cloudglides/glitch/image.png

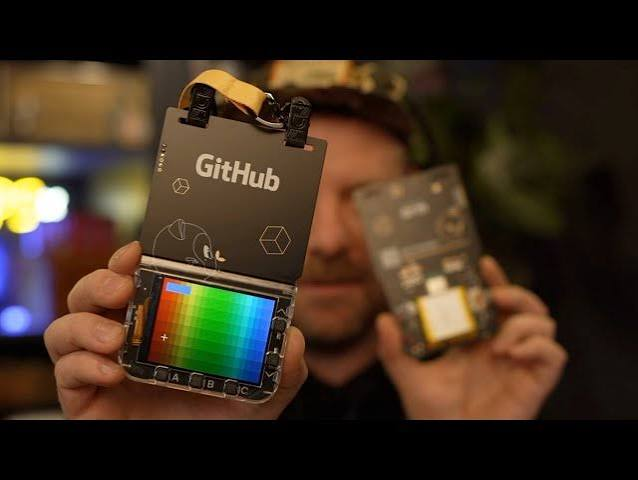
image.png
