cloudglides/glitch/images/1-placement-back-first-try.png

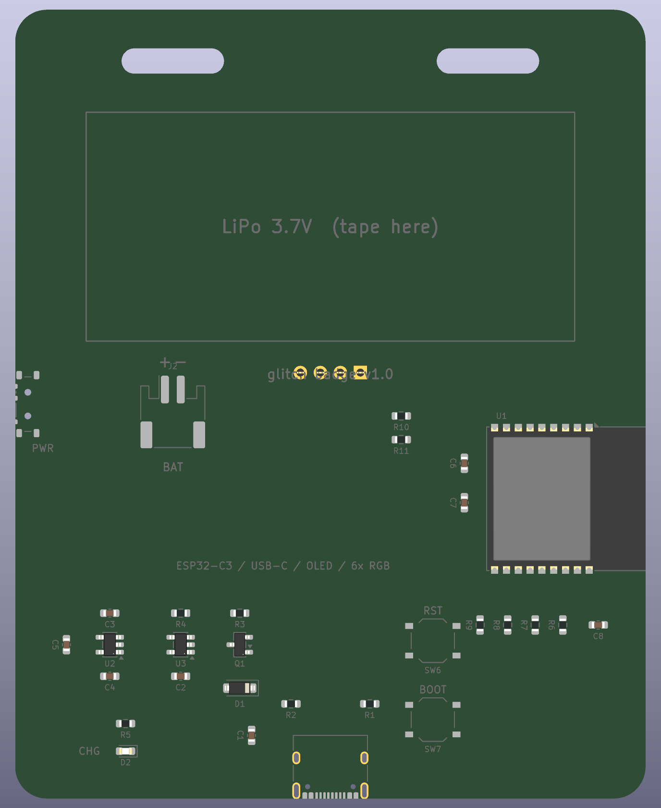
images/1-placement-back-first-try.png
