cloudglides/glitch/images/1-placement-front.png

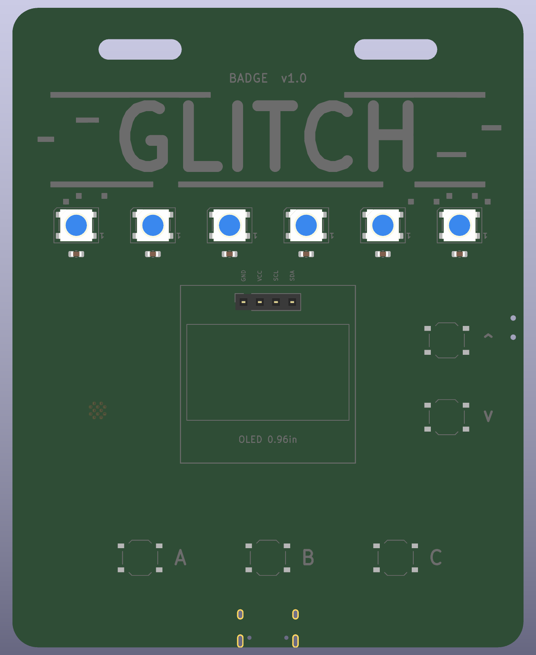
images/1-placement-front.png
