cloudglides/glitch/images/3-routing-back-layout.png

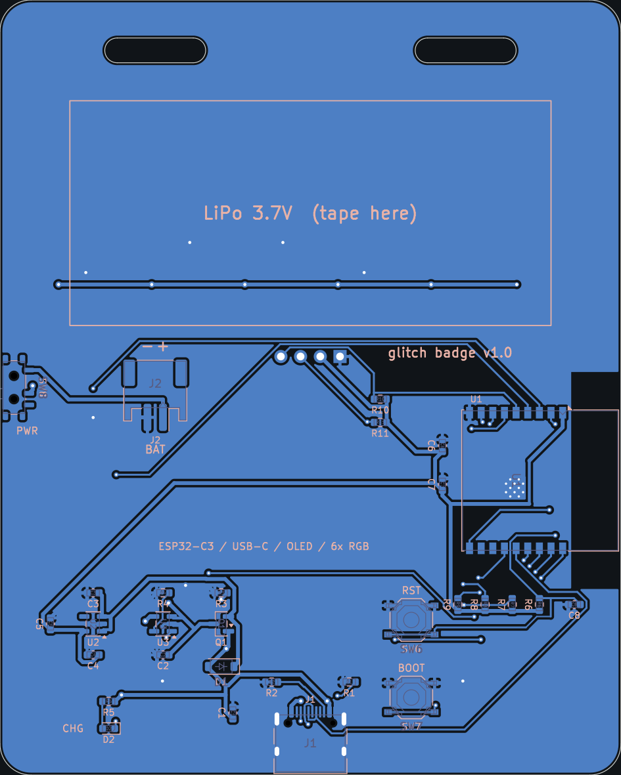
images/3-routing-back-layout.png
