cloudglides/glitch/images/3-routing-copper.png

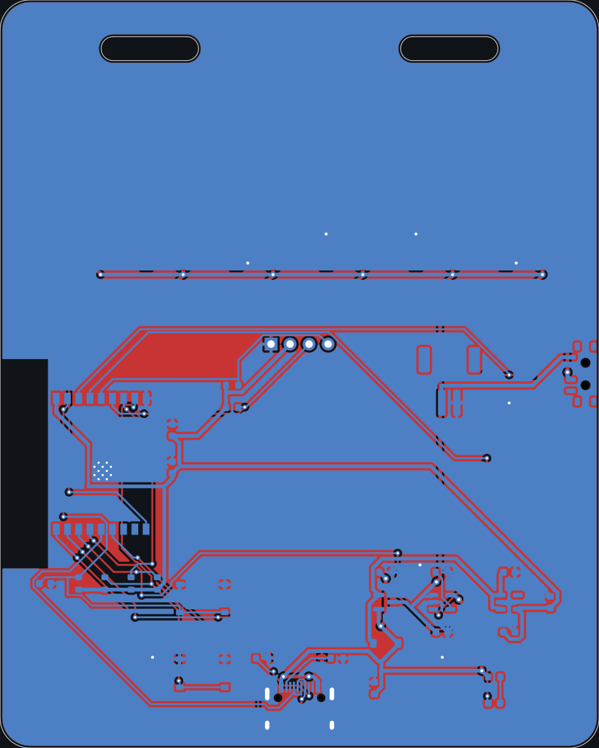
images/3-routing-copper.png
