cloudglides/glitch/BOM.csv

Comment | Designator | Footprint | LCSC Part # | Quantity
10uF | C1,C2,C3,C4,C6 | C_0603_1608Metric | C19702 | 5
100nF | C5,C7,C9,C10,C11,C12,C13,C14 | C_0603_1608Metric | C14663 | 8
1uF | C8 | C_0603_1608Metric | C15849 | 1
B5819W | D1 | D_SOD-123 | C8598 | 1
CHG red | D2 | LED_0603_1608Metric | C2286 | 1
USB-C 16P | J1 | USB_C_Receptacle_HRO_TYPE-C-31-M-12 | C165948 | 1
LiPo JST-PH | J2 | JST_PH_S2B-PH-SM4-TB_1x02-1MP_P2.00mm_Horizontal | C295747 | 1
OLED GND/VCC/SCL/SDA | J3 | PinSocket_1x04_P2.54mm_Vertical | C2718488 | 1
WS2812B | LED1,LED2,LED3,LED4,LED5,LED6 | LED_WS2812B_PLCC4_5.0x5.0mm_P3.2mm | C114586 | 6
AO3401A | Q1 | SOT-23 | C15127 | 1
5.1k | R1,R2,R4 | R_0603_1608Metric | C23186 | 3
100k | R3 | R_0603_1608Metric | C25803 | 1
1k | R5 | R_0603_1608Metric | C21190 | 1
10k | R6,R7,R8,R9 | R_0603_1608Metric | C25804 | 4
4.7k | R10,R11 | R_0603_1608Metric | C23162 | 2
A | SW1 | SW_Push_1P1T_XKB_TS-1187A | C318884 | 1
B | SW2 | SW_Push_1P1T_XKB_TS-1187A | C318884 | 1
C | SW3 | SW_Push_1P1T_XKB_TS-1187A | C318884 | 1
UP | SW4 | SW_Push_1P1T_XKB_TS-1187A | C318884 | 1
DOWN | SW5 | SW_Push_1P1T_XKB_TS-1187A | C318884 | 1
RESET | SW6 | SW_Push_1P1T_XKB_TS-1187A | C318884 | 1
BOOT | SW7 | SW_Push_1P1T_XKB_TS-1187A | C318884 | 1
POWER | SW8 | SW_SPDT_Shouhan_MSK12C02 | C431540 | 1
ESP32-C3-WROOM-02-N4 | U1 | ESP32-C3-WROOM-02 | C2934560 | 1
ME6211C33 | U2 | SOT-23-5 | C82942 | 1
TP4054 | U3 | SOT-23-5 | C32574 | 1
