cloudglides/glitch/docs/glitch-schematic.pdf

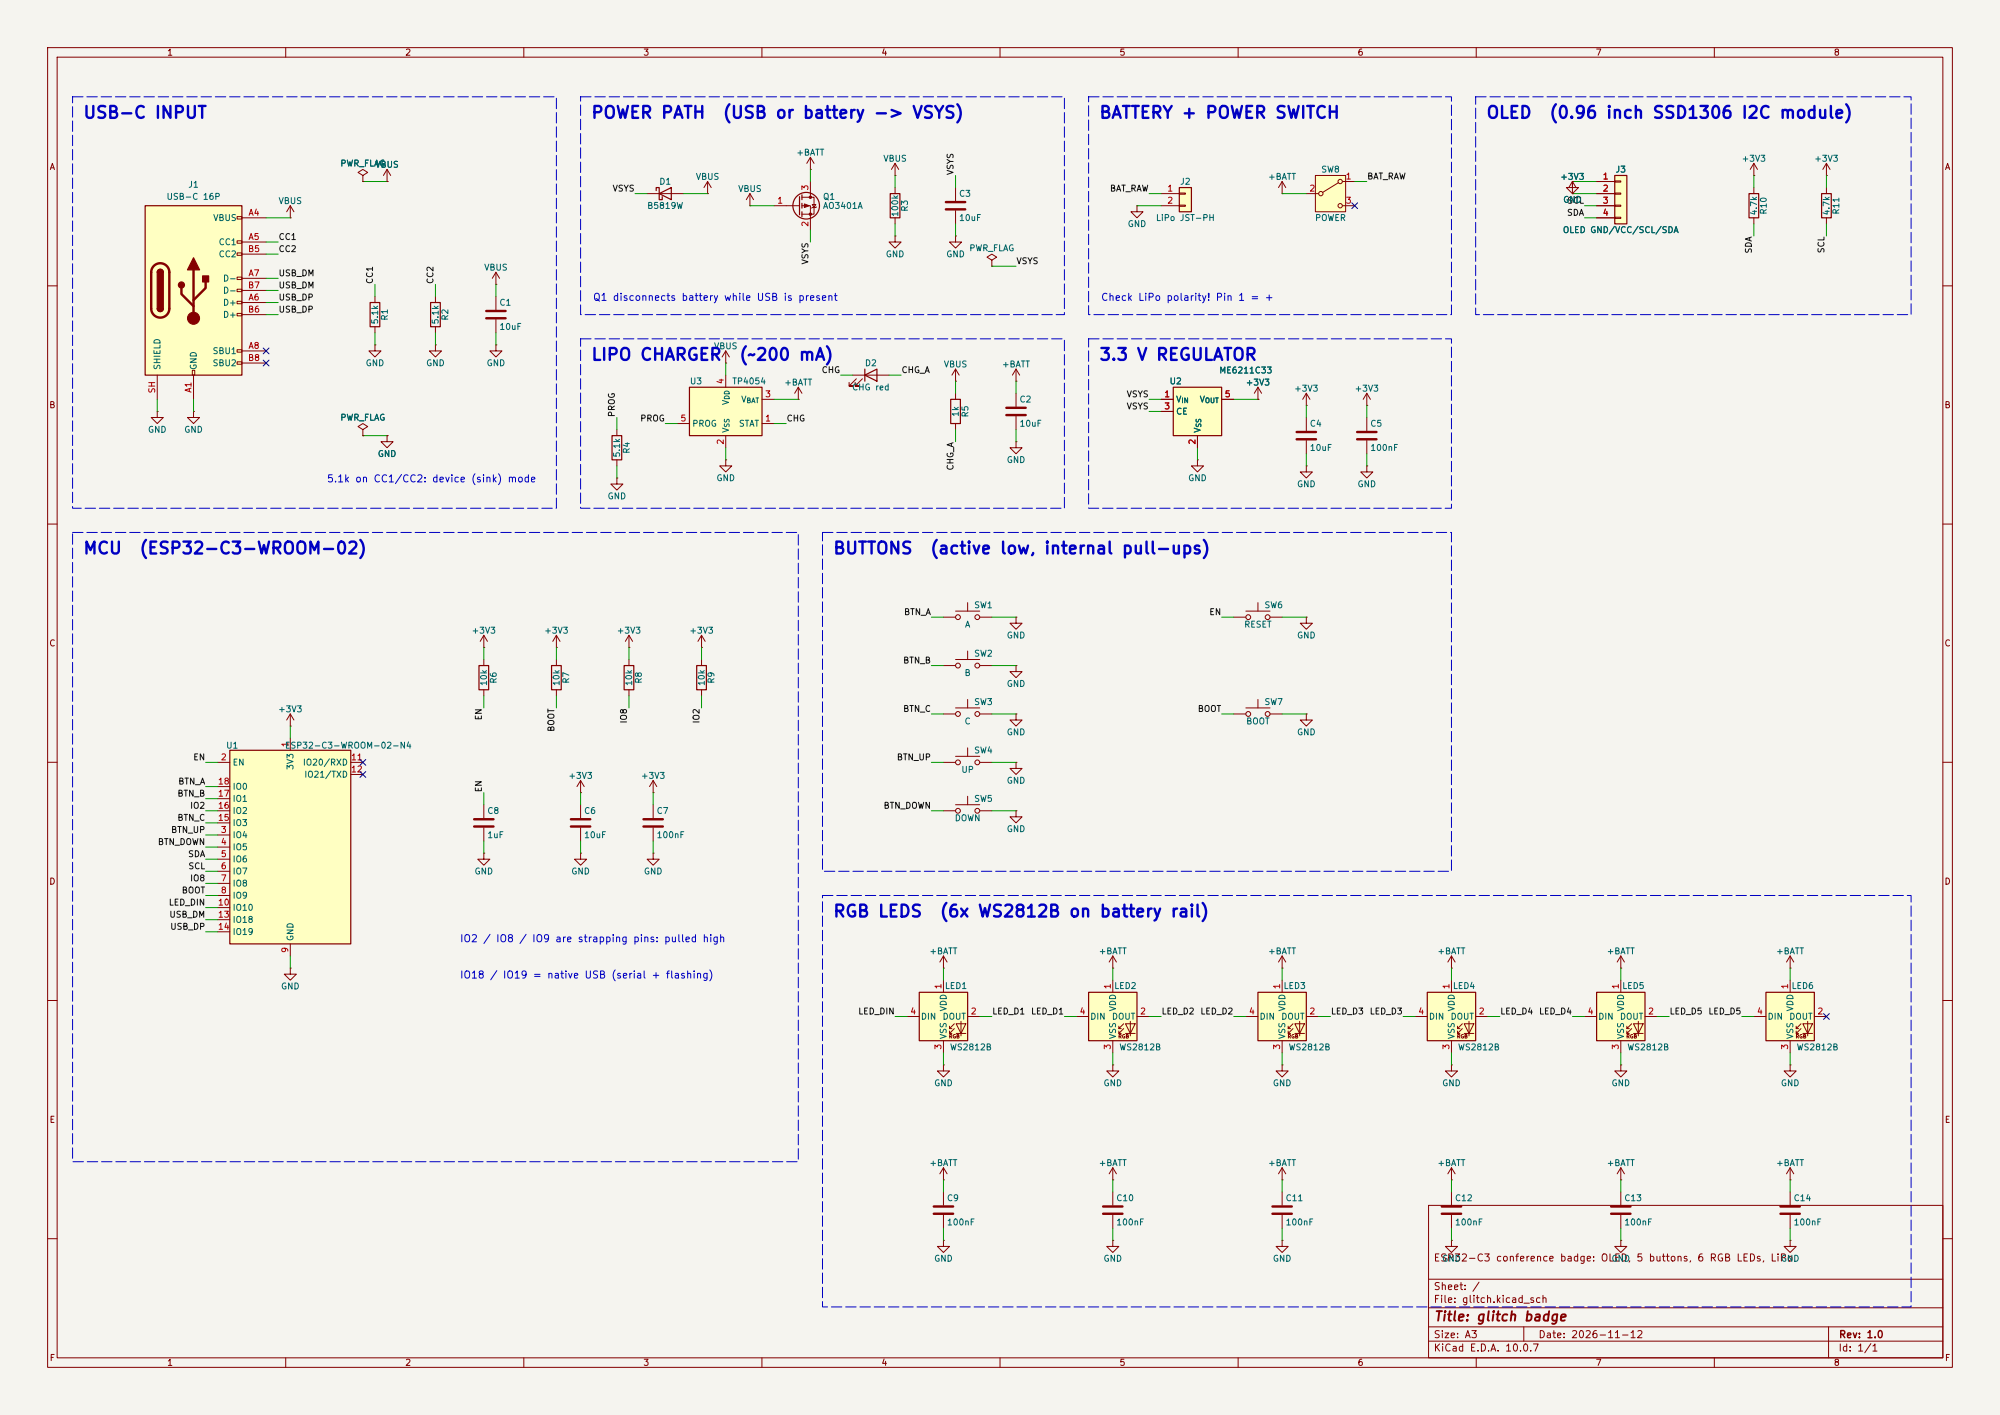
[picture p12: page 1]

POWER PATH (USB or battery -> VSYS)

J3 OLED GND/VCC/SCL/SDA +3V3 GND

Q1 disconnects battery while USB is present

Check LiPo polarity! Pin 1 = +

VDD 4 PROG 5 U3 TP4054 D2 CHG red GND +3V3 +3V3 C6

5.1k on CC1/CC2: device (sink) mode

RGB LEDS (6x WS2812B on battery rail)

IO2 / IO8 / IO9 are strapping pins: pulled high

IO18 / IO19 = native USB (serial + flashing)

ESP32-C3 conference badge: OLED, 5 buttons, 6 RGB LEDs, LiPo

GND

Sheet: / File: glitch.kicad_sch

Size: A3 | Rev: 1.0 | F Date: 2026-11-12
KiCad E.D.A. 10.0.7 | Id: 1/1
