cloudglides/glitch/pcb/glitch.kicad_pcb

## KiCad design pcb/glitch.kicad_pcb (2026-11-11)

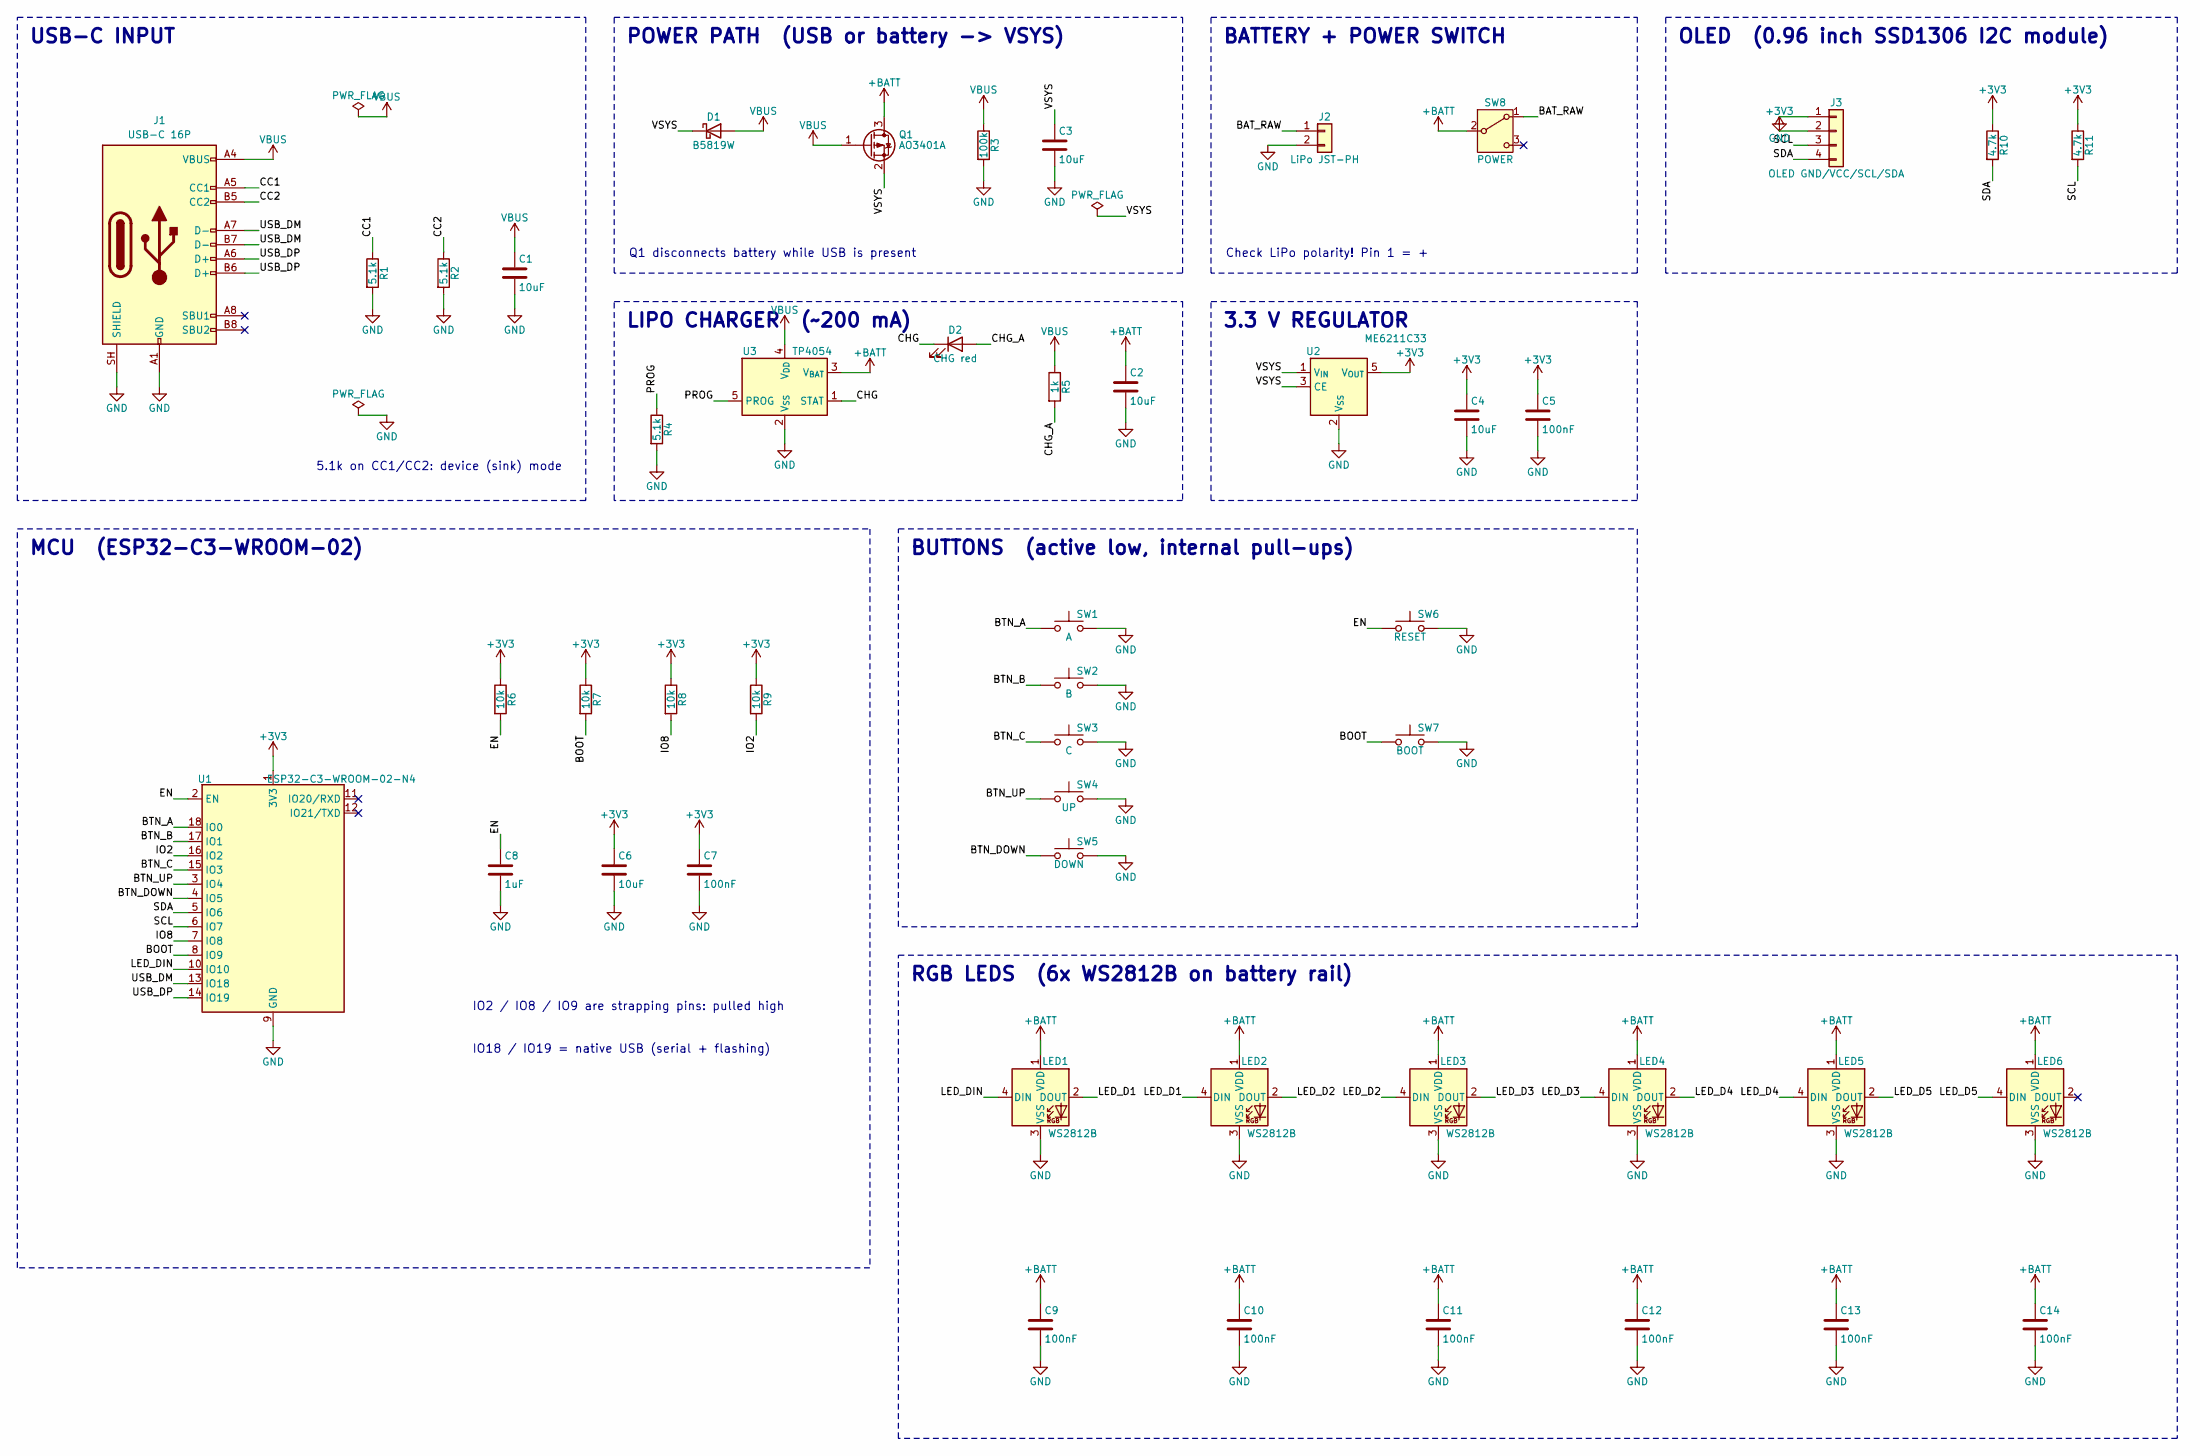
[picture p13: schematic glitch.kicad_sch, glitch badge]

Parts:
C1, C2, C3, C4, C6: 10uF; C_0603_1608Metric; LCSC C19702
C5, C7, C9, C10, C11, C12, C13, C14: 100nF; C_0603_1608Metric; LCSC C14663
C8: 1uF; C_0603_1608Metric; LCSC C15849
D1: B5819W; D_SOD-123; LCSC C8598
D2: CHG red; LED_0603_1608Metric; LCSC C2286
J1: USB-C 16P; USB_C_Receptacle_HRO_TYPE-C-31-M-12; LCSC C165948
J2: LiPo JST-PH; JST_PH_S2B-PH-SM4-TB_1x02-1MP_P2.00mm_Horizontal; LCSC C295747
J3: OLED GND/VCC/SCL/SDA; PinSocket_1x04_P2.54mm_Vertical; LCSC C2718488
LED1, LED2, LED3, LED4, LED5, LED6: WS2812B; LED_WS2812B_PLCC4_5.0x5.0mm_P3.2mm; LCSC C114586
Q1: AO3401A; SOT-23; LCSC C15127
R1, R2, R4: 5.1k; R_0603_1608Metric; LCSC C23186
R3: 100k; R_0603_1608Metric; LCSC C25803
R5: 1k; R_0603_1608Metric; LCSC C21190
R6, R7, R8, R9: 10k; R_0603_1608Metric; LCSC C25804
R10, R11: 4.7k; R_0603_1608Metric; LCSC C23162
SW1: A; SW_Push_1P1T_XKB_TS-1187A; LCSC C318884
SW2: B; SW_Push_1P1T_XKB_TS-1187A; LCSC C318884
SW3: C; SW_Push_1P1T_XKB_TS-1187A; LCSC C318884
SW4: UP; SW_Push_1P1T_XKB_TS-1187A; LCSC C318884
SW5: DOWN; SW_Push_1P1T_XKB_TS-1187A; LCSC C318884
SW6: RESET; SW_Push_1P1T_XKB_TS-1187A; LCSC C318884
SW7: BOOT; SW_Push_1P1T_XKB_TS-1187A; LCSC C318884
SW8: POWER; SW_SPDT_Shouhan_MSK12C02; LCSC C431540
U1: ESP32-C3-WROOM-02-N4; ESP32-C3-WROOM-02; LCSC C2934560
U2: ME6211C33; SOT-23-5; LCSC C82942
U3: TP4054; SOT-23-5; LCSC C32574

Connections:
+3V3: C4.1, C5.1, C6.1, C7.1, J3.2, R6.1, R7.1, R8.1, R9.1, R10.1, R11.1, U1.1 (3V3), U2.5 (V_{OUT})
+BATT: C2.1, C9.1, C10.1, C11.1, C12.1, C13.1, C14.1, LED1.1 (VDD), LED2.1 (VDD), LED3.1 (VDD), LED4.1 (VDD), LED5.1 (VDD), LED6.1 (VDD), Q1.3 (D), SW8.2 (B), U3.3 (V_{BAT})
/BAT_RAW: J2.1, SW8.1 (A)
/BOOT: R7.2, SW7.1, U1.8 (IO9)
/BTN_A: SW1.1, U1.18 (IO0)
/BTN_B: SW2.1, U1.17 (IO1)
/BTN_C: SW3.1, U1.15 (IO3)
/BTN_DOWN: SW5.1, U1.4 (IO5)
/BTN_UP: SW4.1, U1.3 (IO4)
/CC1: J1.A5 (CC1), R1.1
/CC2: J1.B5 (CC2), R2.1
/CHG: D2.1 (K), U3.1 (STAT)
/CHG_A: D2.2 (A), R5.2
/EN: C8.1, R6.2, SW6.1, U1.2 (EN)
/IO2: R9.2, U1.16 (IO2)
/IO8: R8.2, U1.7 (IO8)
/LED_D1: LED1.2 (DOUT), LED2.4 (DIN)
/LED_D2: LED2.2 (DOUT), LED3.4 (DIN)
/LED_D3: LED3.2 (DOUT), LED4.4 (DIN)
/LED_D4: LED4.2 (DOUT), LED5.4 (DIN)
/LED_D5: LED5.2 (DOUT), LED6.4 (DIN)
/LED_DIN: LED1.4 (DIN), U1.10 (IO10)
/PROG: R4.1, U3.5 (PROG)
/SCL: J3.3, R11.2, U1.6 (IO7)
/SDA: J3.4, R10.2, U1.5 (IO6)
/USB_DM: J1.A7 (D-), J1.B7 (D-), U1.13 (IO18)
/USB_DP: J1.A6 (D+), J1.B6 (D+), U1.14 (IO19)
/VSYS: C3.1, D1.1 (K), Q1.2 (S), U2.1 (V_{IN}), U2.3 (CE)
GND: C1.2, C2.2, C3.2, C4.2, C5.2, C6.2, C7.2, C8.2, C9.2, C10.2, C11.2, C12.2, C13.2, C14.2, J1.A1 (GND), J1.A12 (GND), J1.B1 (GND), J1.B12 (GND), J1.SH (SHIELD), J2.2, J3.1, LED1.3 (VSS), LED2.3 (VSS), LED3.3 (VSS), LED4.3 (VSS), LED5.3 (VSS), LED6.3 (VSS), R1.2, R2.2, R3.2, R4.2, SW1.2, SW2.2, SW3.2, SW4.2, SW5.2, SW6.2, SW7.2, U1.9 (GND), U1.19 (GND), U2.2 (V_{SS}), U3.2 (V_{SS})
VBUS: C1.1, D1.2 (A), J1.A4 (VBUS), J1.A9 (VBUS), J1.B4 (VBUS), J1.B9 (VBUS), Q1.1 (G), R3.1, R5.1, U3.4 (V_{DD})

Notes on the sheet:
USB-C INPUT
5.1k on CC1/CC2: device (sink) mode
POWER PATH (USB or battery -> VSYS)
Q1 disconnects battery while USB is present
LIPO CHARGER (~200 mA)
BATTERY + POWER SWITCH
Check LiPo polarity! Pin 1 = +
3.3 V REGULATOR
OLED (0.96 inch SSD1306 I2C module)
MCU (ESP32-C3-WROOM-02)
IO2 / IO8 / IO9 are strapping pins: pulled high
IO18 / IO19 = native USB (serial + flashing)
BUTTONS (active low, internal pull-ups)
RGB LEDS (6x WS2812B on battery rail)

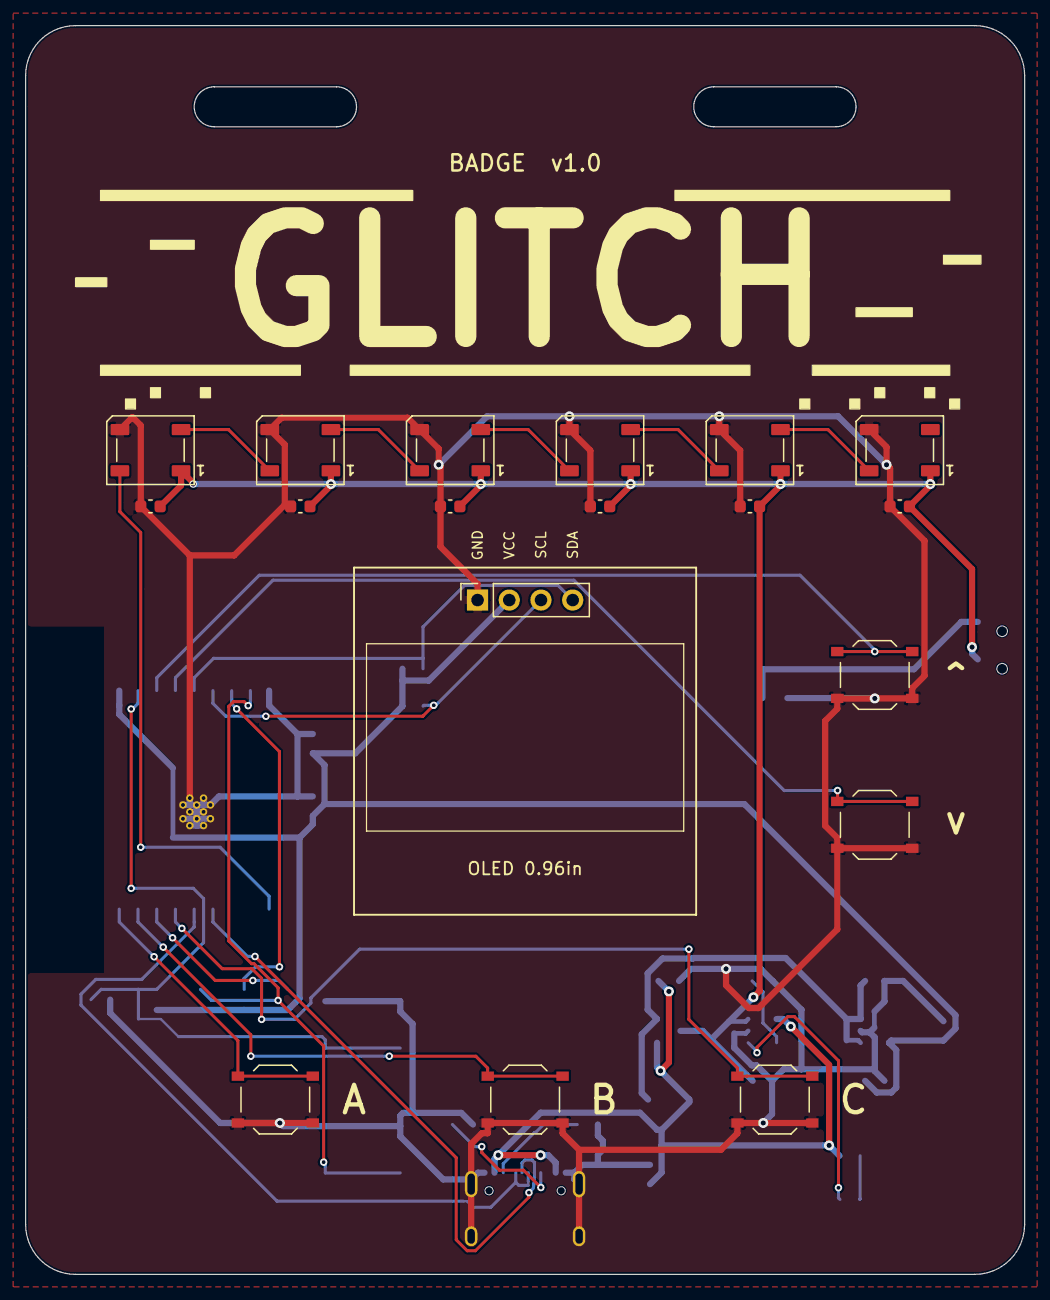
[picture p14: board glitch.kicad_pcb from above]

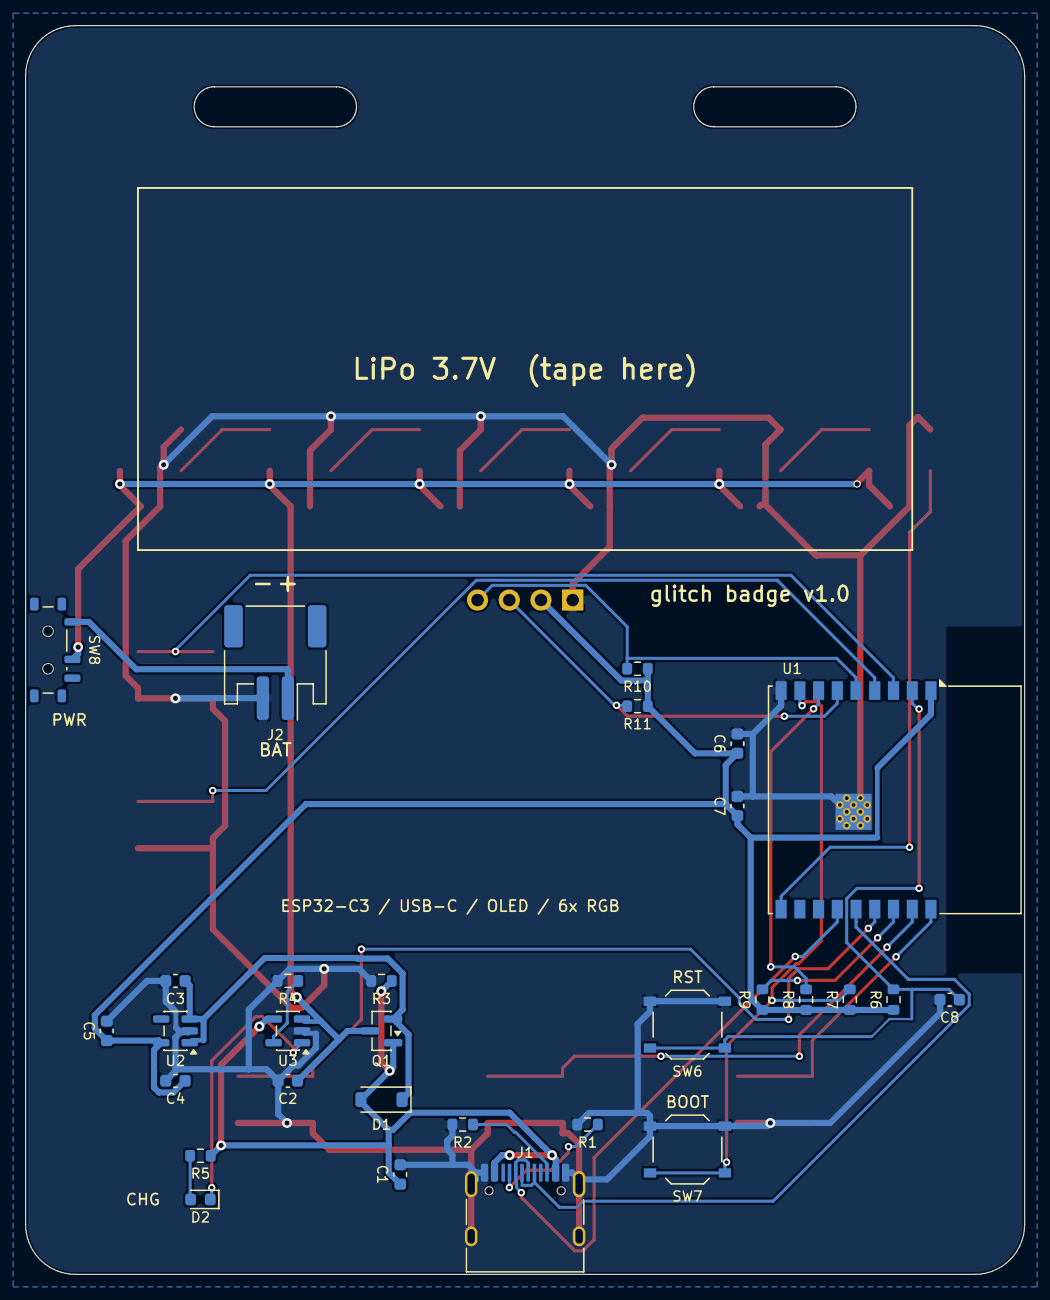
[picture p15: board glitch.kicad_pcb from below]

Board: 2 copper layers, 80.0 x 100.0 mm, 48 parts (30 on the bottom side), 30 nets.
