cloudglides/glitch/(commit log)

2026-11-11 hey there!!
    [BOM.csv, glitch.kicad_pcb, glitch.kicad_sch]
2026-11-11 Update journals for GLITCH project progress
    Document progress on the GLITCH wearable badge project, detailing schematic design, PCB layout, routing, and final checks.
